matthartpi/Hovercopter/HandPlacingPoles/MatthewTravis_ENGR454_Milestone7_HandPlacingPoles/FBD.png

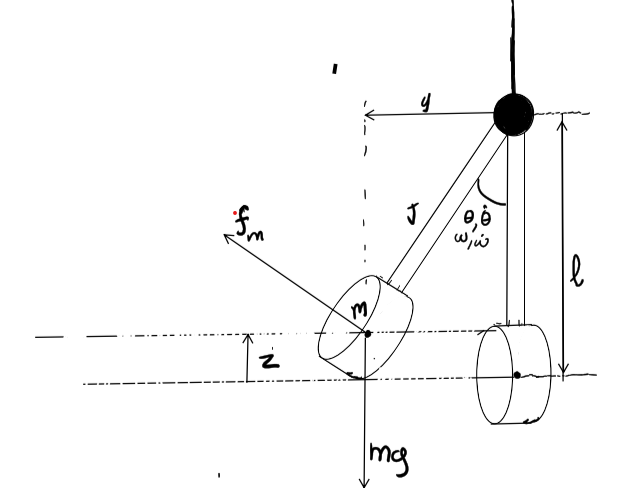
HandPlacingPoles/MatthewTravis_ENGR454_Milestone7_HandPlacingPoles/FBD.png
