matthartpi/Hovercopter/HoverCopter-master/User Library-PJ-002AH.STEP

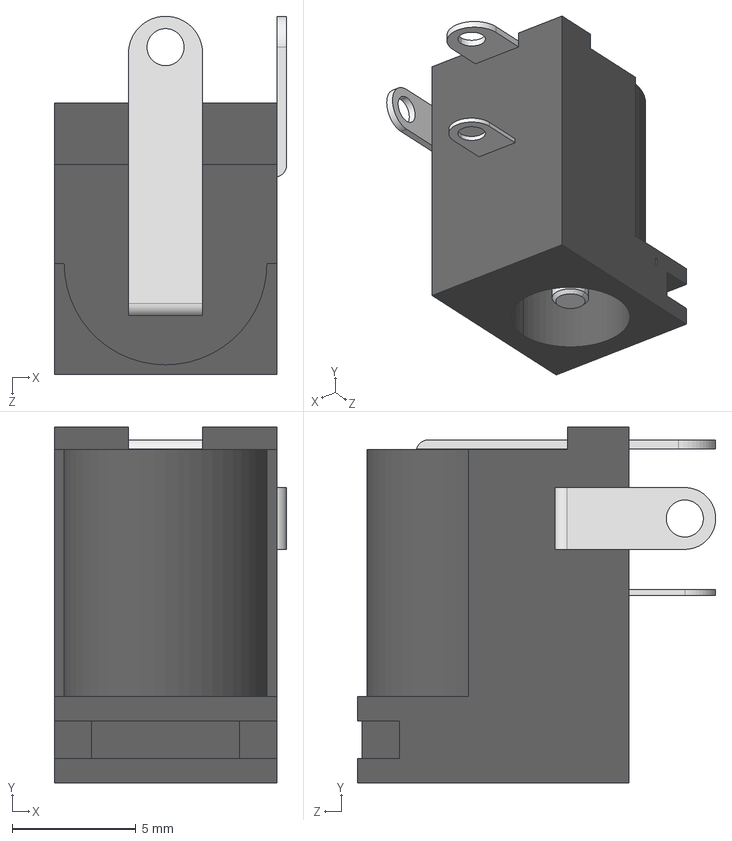
[picture p12: CAD file, 2021-05-20]
HoverCopter-master/User Library-PJ-002AH.STEP
9.40 x 14.4 x 14.5 mm
