matthartpi/Hovercopter/HoverCopter-master/Hover Copters.pdf

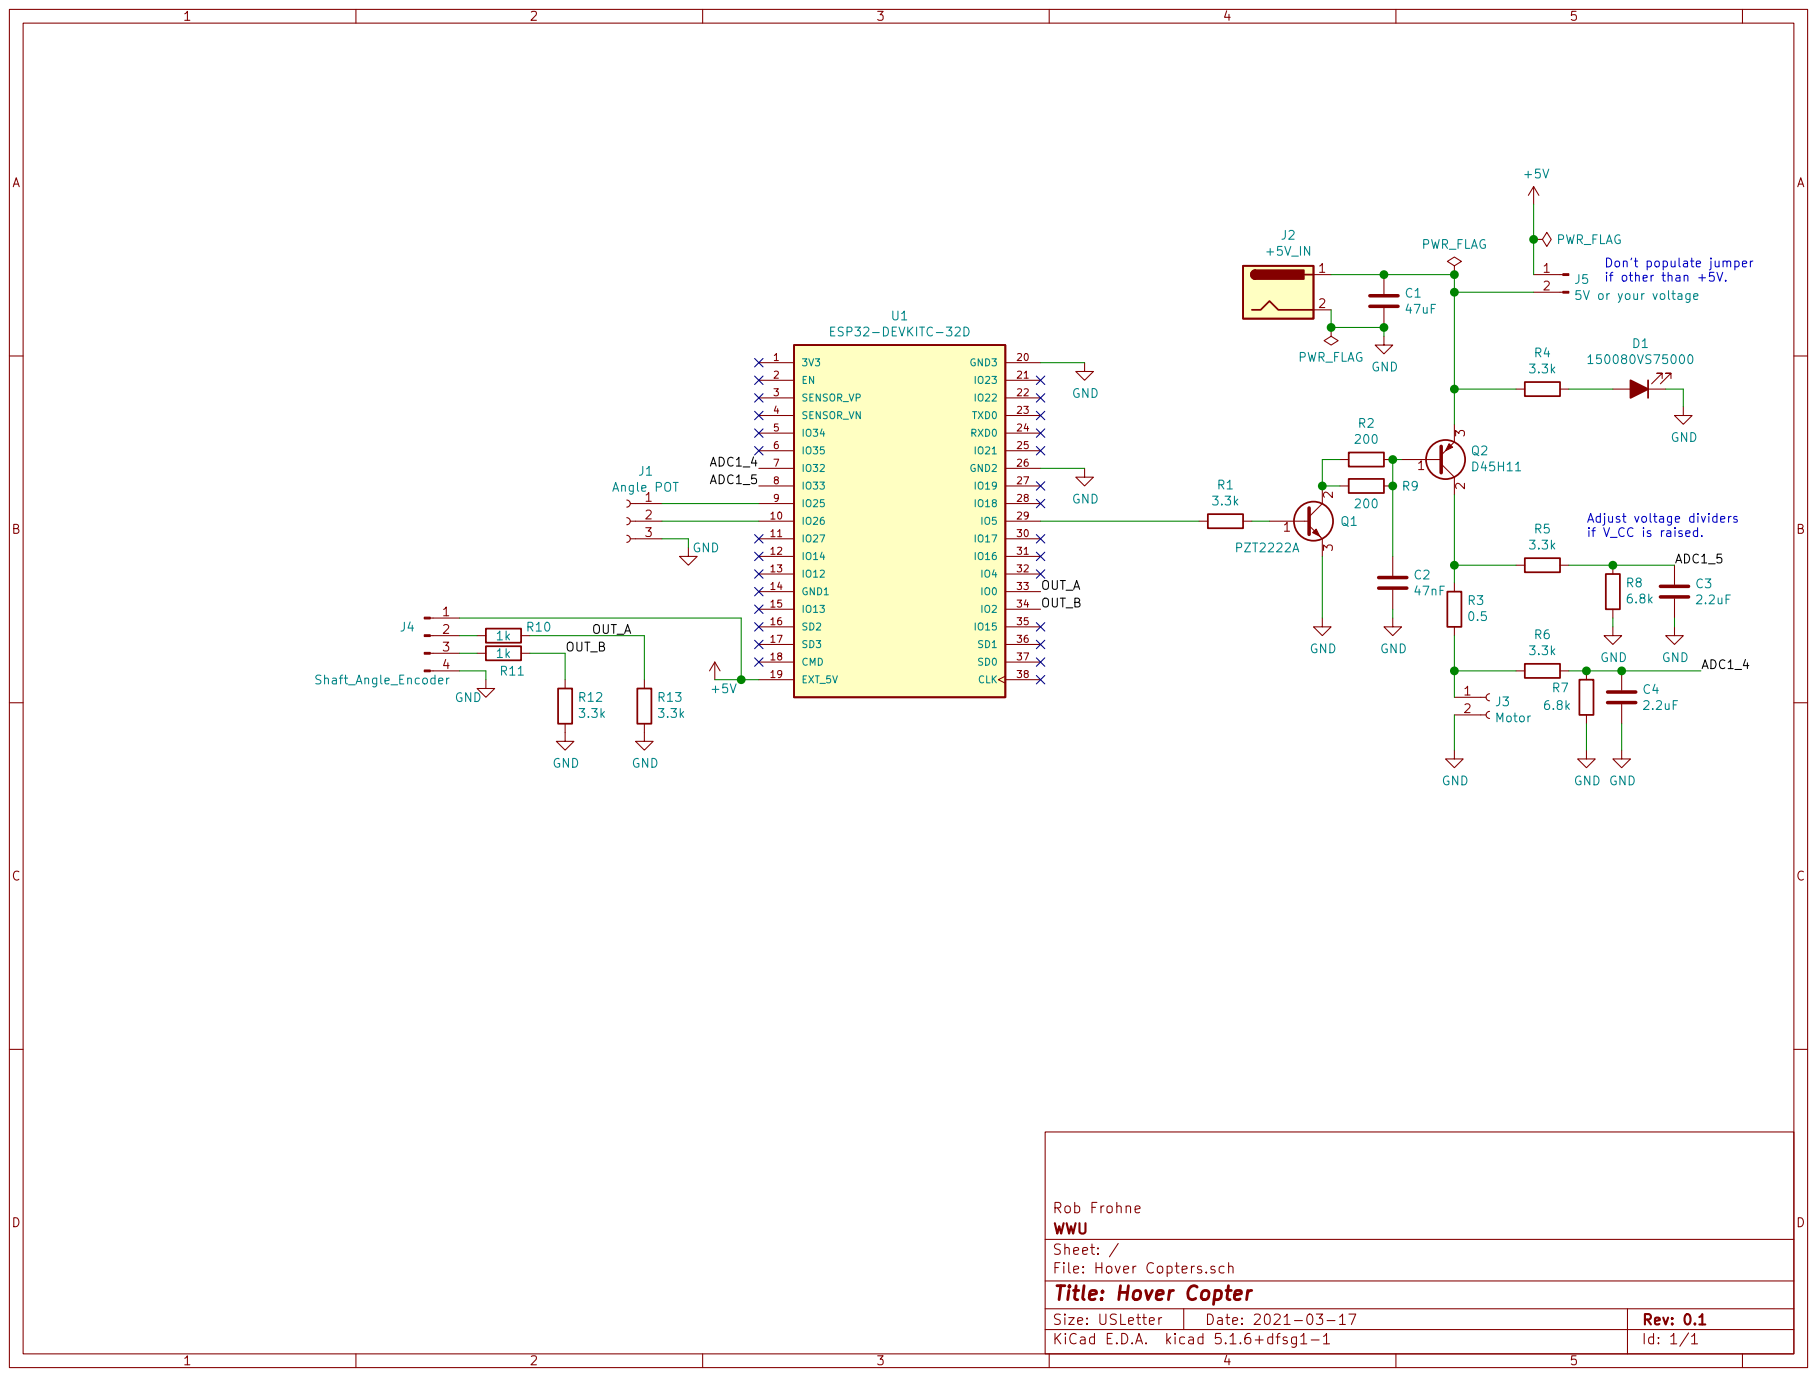
[picture p18: page 1]

Rob Frohne
File: Hover Copters.sch Sheet: / WWU

Id: 1/1 Title: Hover Copter
