matthartpi/Hovercopter/HoverCopter-master/Hover Copters.kicad_pcb

## KiCad design HoverCopter-master/Hover Copters.kicad_pcb (2021-05-20)

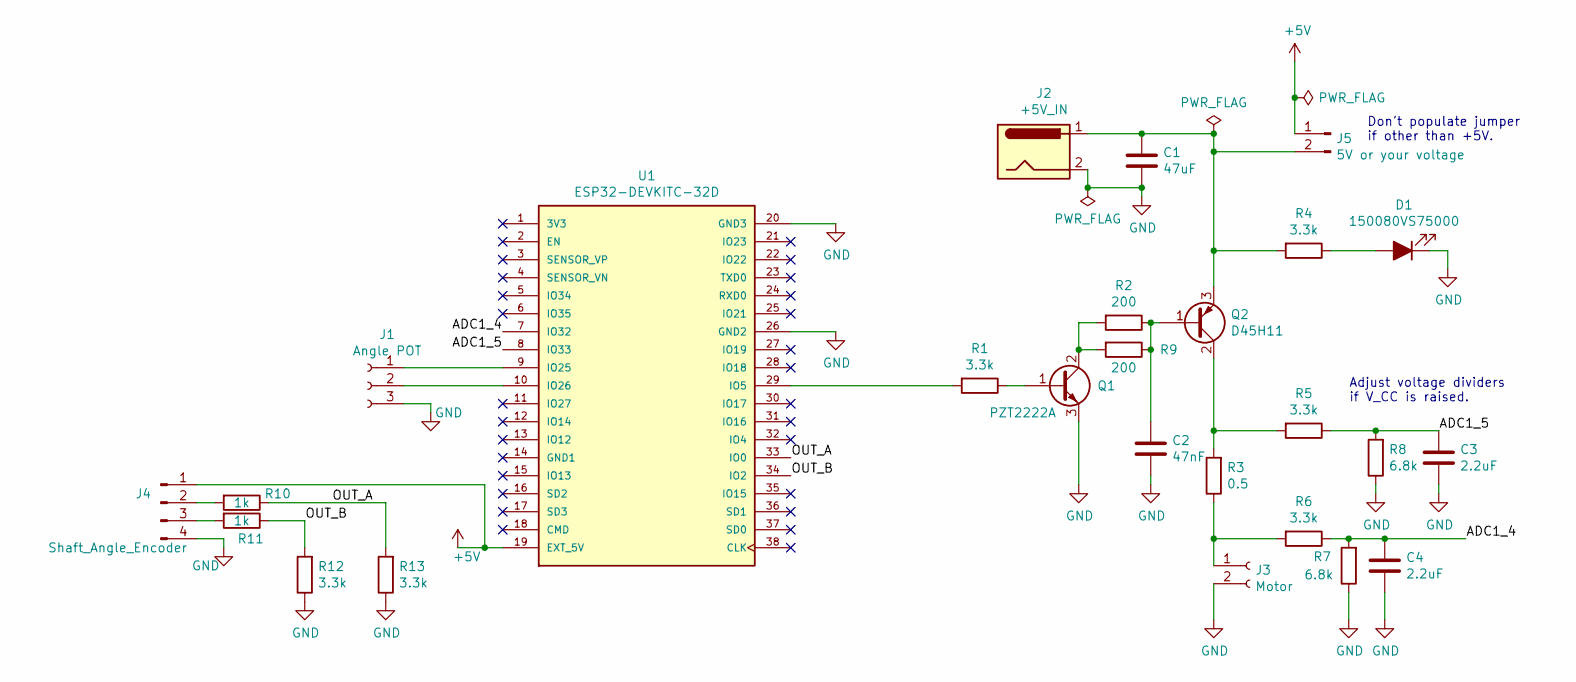
[picture p19: schematic Hover Copters.sch, Hover Copter]

Parts:
C1: 47uF; C_0805_2012Metric
C2: 47nF; C_0805_2012Metric
C3, C4: 2.2uF; C_0805_2012Metric
D1: 150080VS75000; LED_0805_2012Metric
J1: Angle POT; PinHeader_1x03_P2.54mm_Vertical
J2: +5V_IN; BarrelJack_Horizontal
J3: Motor; PinSocket_1x02_P2.54mm_Vertical
J4: Shaft_Angle_Encoder; PinHeader_1x04_P2.54mm_Vertical
J5: 5V or your voltage; PinHeader_1x02_P2.54mm_Vertical
Q1: PZT2222A; SOT-223-3_TabPin2
Q2: D45H11; TO-220-3_Vertical
R1, R4, R5, R6, R12, R13: 3.3k; R_0805_2012Metric
R2, R9: 200; R_0805_2012Metric
R3: 0.5; R_0805_2012Metric
R7, R8: 6.8k; R_0805_2012Metric
R10, R11: 1k; R_0805_2012Metric
U1: ESP32-DEVKITC-32D; MODULE_ESP32-DEVKITC-32D; PARTREV 4

Connections:
+5V: J4.1, J5.1, U1.19 (EXT_5V)
/ADC1_4: C4.1, R6.1, R7.2, U1.7 (IO32)
/ADC1_5: C3.1, R5.1, R8.2, U1.8 (IO33)
/OUT_A: R10.1, R13.2, U1.33 (IO0)
/OUT_B: R11.1, R12.2, U1.34 (IO2)
GND: C1.2, C2.2, C3.2, C4.2, D1.1 (K), J1.3, J2.2, J3.2, J4.4, Q1.3 (E), R7.1, R8.1, R12.1, R13.1, U1.20 (GND3), U1.26 (GND2)
unnamed: C1.1, J2.1, J5.2, Q2.3 (E), R4.2
unnamed: C2.1, Q2.1 (B), R2.1, R9.1
unnamed: D1.2 (A), R4.1
unnamed: J1.1, U1.9 (IO25)
unnamed: J1.2, U1.10 (IO26)
unnamed: J3.1, R3.1, R6.2
unnamed: J4.2, R10.2
unnamed: J4.3, R11.2
unnamed: Q1.1 (B), R1.1
unnamed: Q1.2 (C), R2.2, R9.2
unnamed: Q2.2 (C), R3.2, R5.2
unnamed: R1.2, U1.29 (IO5)

Notes on the sheet:
Adjust voltage dividers if V_CC is raised.
Don't populate jumper if other than +5V.

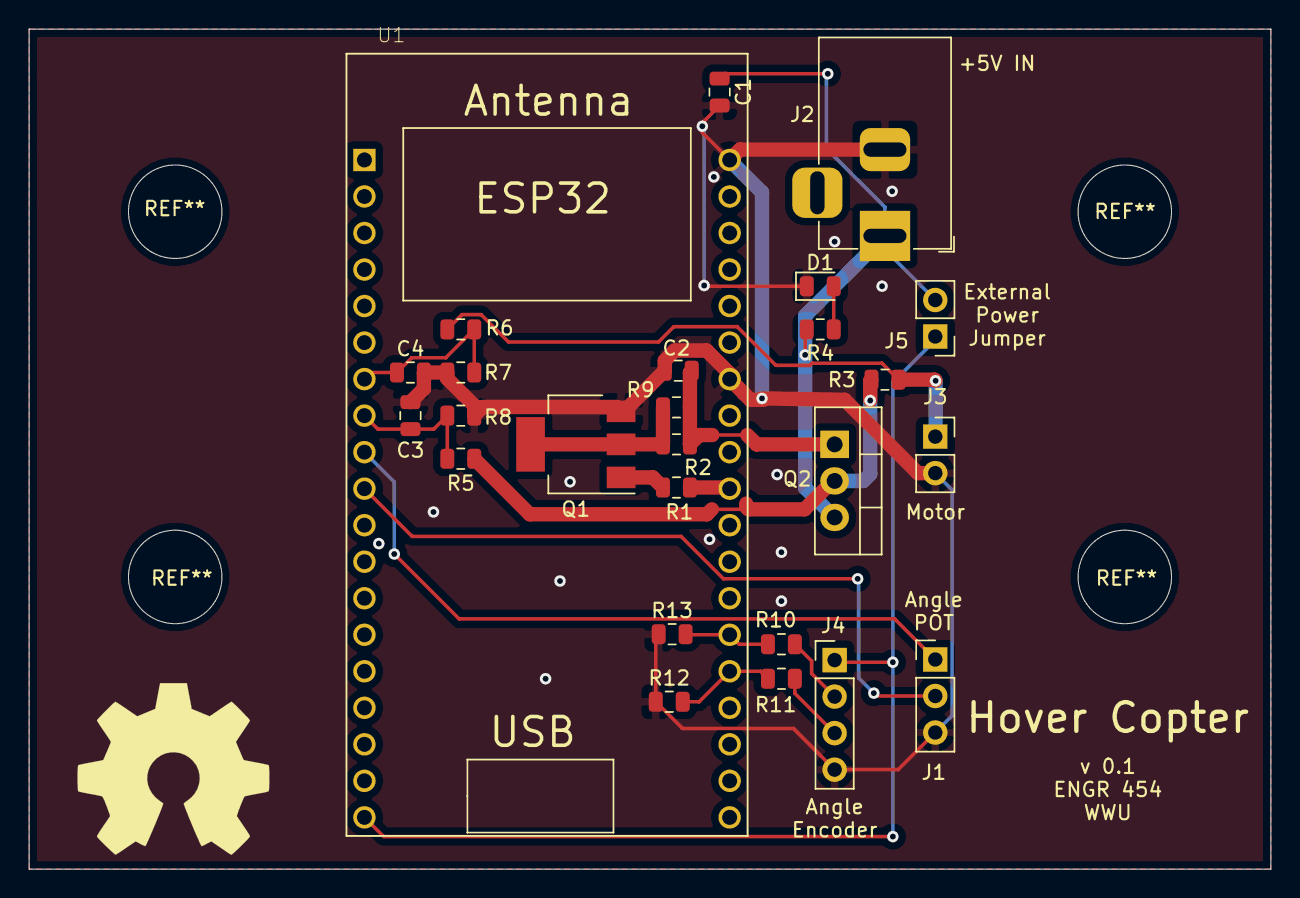
[picture p20: board Hover Copters.kicad_pcb from above]

Board: 2 copper layers, 86.4 x 58.4 mm, 26 parts (0 on the bottom side), 18 nets.
