matthartpi/Hovercopter/(commit log)

2021-05-21 Deleted old hanging down data
    [HangingDownData.csv, from_horizontal_1621359664881.csv, from_horizontalr2_1621360628023.csv]
2021-05-28 Kind of working?
    [serialtest.csv]
2021-06-01 pin numbers
2021-06-03 Fixed name of HandPlacingPoles2.ino
    [HandPlacingPoles2.ino]
2021-06-03 Fixed naming of files in folders
    [serialtest.csv]
2021-06-03 Added *1023 to PWM (small signal) calculation
2021-06-03 Revert "changes"
    This reverts commit df3aee7b4f14da7411de9390fc50d1eb0869b8a6.
    [HandPlacingPoles2.ino]
2021-06-09 kalman filter sim
2021-06-09 Adding process and flow of project to README.md
2021-06-09 Moved files and folders out of and deleted Hover Copter - General
    [HangingDownData.csv, Hover Copters(1).sch, Hover Copters.kicad_pcb, Hover Copters.sch, MotorPWMvsThrust&CurrentDraw.ods, MotorPWMvsThrust&CurrentDraw.xlsx, User Library-PJ-002AH.STEP, serialtest.csv]
